coenca-ni/PF-EsterMesquita-SIM/01-Aplicativo/README.md

# Programação em Blocos do Aplicativo

Este diretório contém a programação em blocos do aplicativo desenvolvida utilizando a plataforma Kodular. Os blocos representam a lógica de navegação, controle de rede e outras funcionalidades do aplicativo. Cada bloco possui uma função específica e contribui para a funcionalidade geral do sistema.

## Estrutura dos Blocos

- **Navegação entre Telas**: Blocos que controlam a navegação entre diferentes telas do aplicativo.
- **Controle de Conectividade**: Blocos responsáveis por gerenciar conexões WiFi e resetar o sistema em caso de perda de conexão.
- **Notificações**: Blocos que exibem mensagens ao usuário para indicar ações necessárias, como conexão à rede WiFi.
- **Animações e Interações**: Blocos que configuram animações e interações para melhorar a experiência do usuário.

## Telas
Na pasta tela estão contidos exemplos dos resultados da elaboração das telas através do design do aplicativo Kodular.

## Ícones e outras Imagens
Nesta pasta estão contidos os ícones e imagens utilizados no aplicativo.
