coenca-ni/PF-EsterMesquita-SIM/00-Códigos/MATLAB/chuva_outubro.png

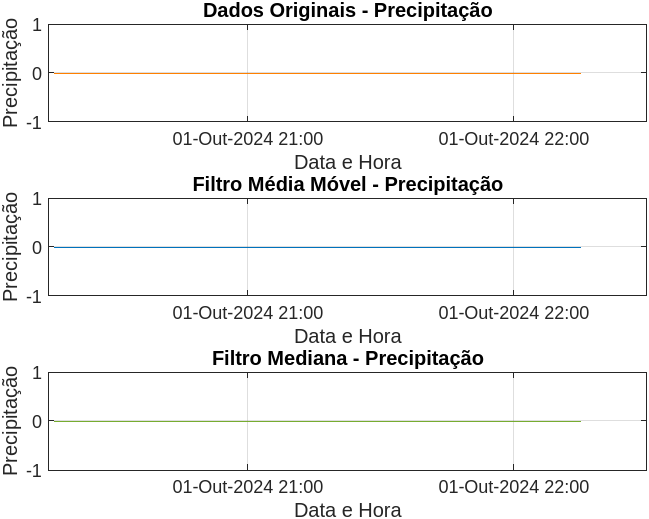
00-Códigos/MATLAB/chuva_outubro.png
