coenca-ni/PF-EsterMesquita-SIM/00-Códigos/MATLAB/indice_uv_outubro.png

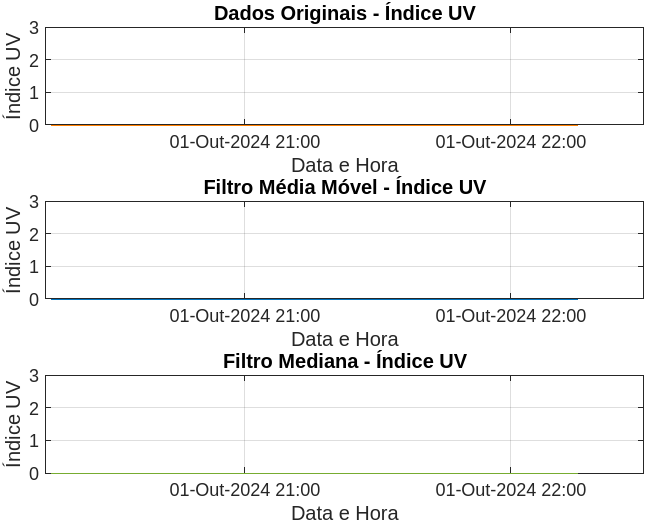
00-Códigos/MATLAB/indice_uv_outubro.png
