coenca-ni/PF-EsterMesquita-SIM/00-Códigos/MATLAB/indiceUV.png

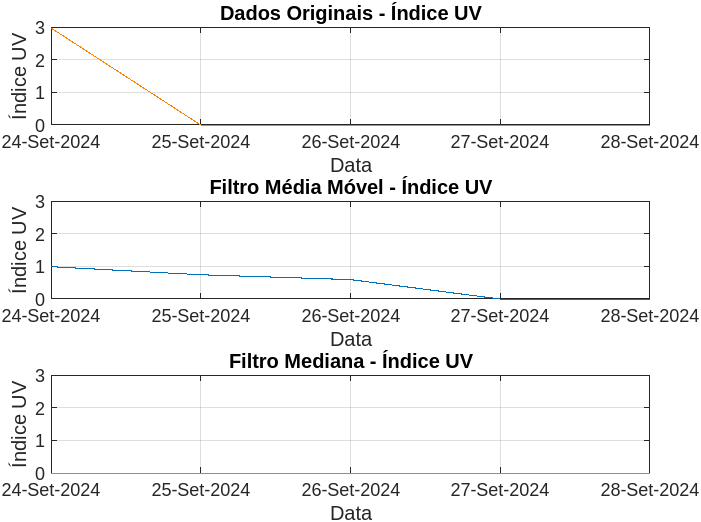
00-Códigos/MATLAB/indiceUV.png
