coenca-ni/PF-EsterMesquita-SIM/00-Códigos/MATLAB/precipitacao.png

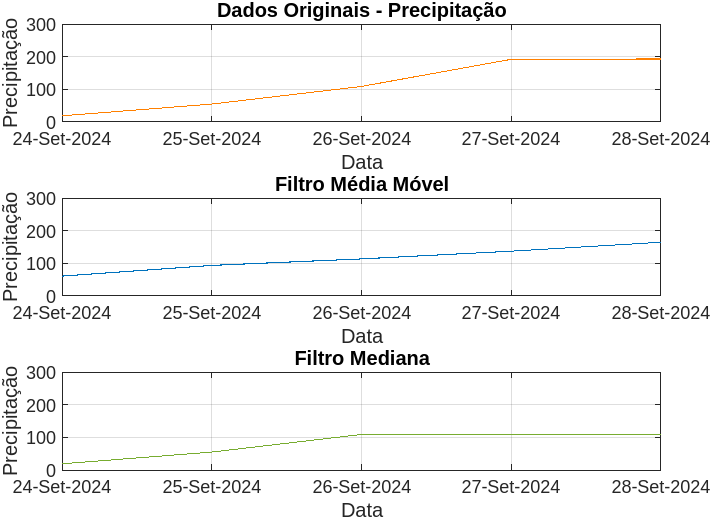
00-Códigos/MATLAB/precipitacao.png
