coenca-ni/PF-EsterMesquita-SIM/00-Códigos/MATLAB/pressao_outubro.png

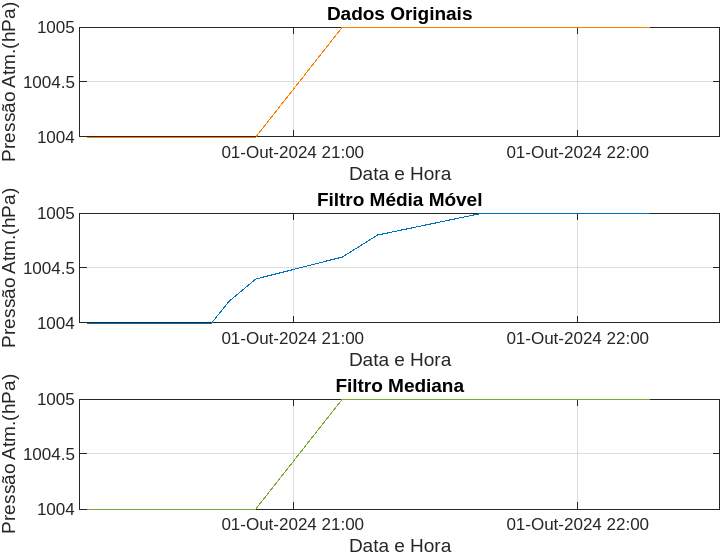
00-Códigos/MATLAB/pressao_outubro.png
