coenca-ni/PF-EsterMesquita-SIM/00-Códigos/MATLAB/QT_outubropng.png

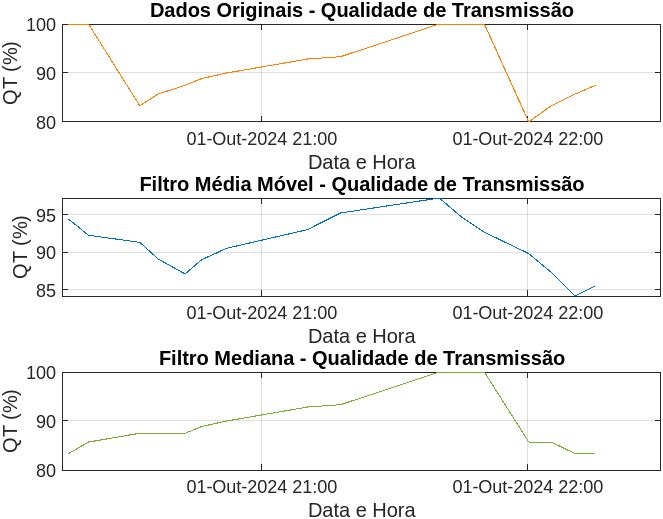
00-Códigos/MATLAB/QT_outubropng.png
