coenca-ni/PF-EsterMesquita-SIM/00-Códigos/MATLAB/temperatura_outubro.png

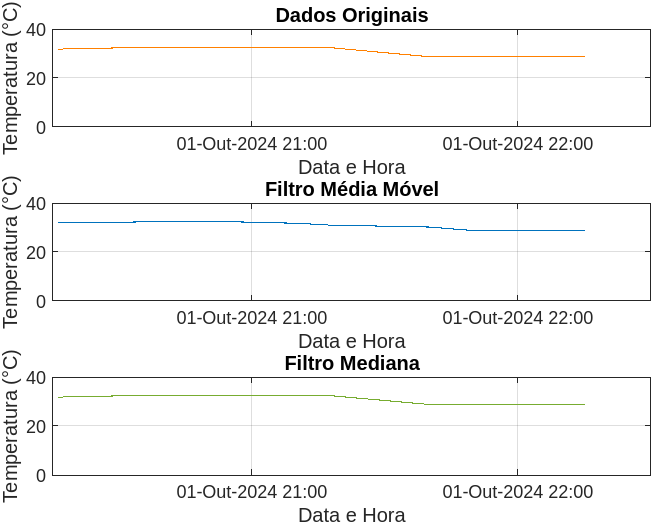
00-Códigos/MATLAB/temperatura_outubro.png
