coenca-ni/PF-EsterMesquita-SIM/00-Códigos/MATLAB/tpp_outubro.png

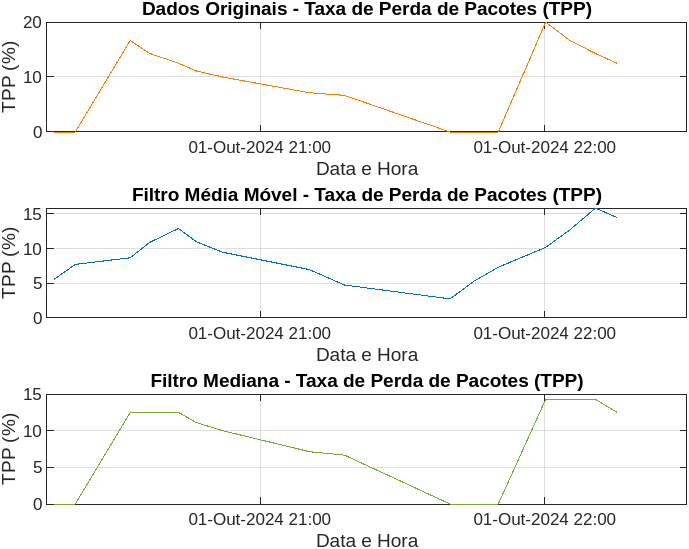
00-Códigos/MATLAB/tpp_outubro.png
