coenca-ni/PF-EsterMesquita-SIM/01-Aplicativo/Blocos/blocks (1).png

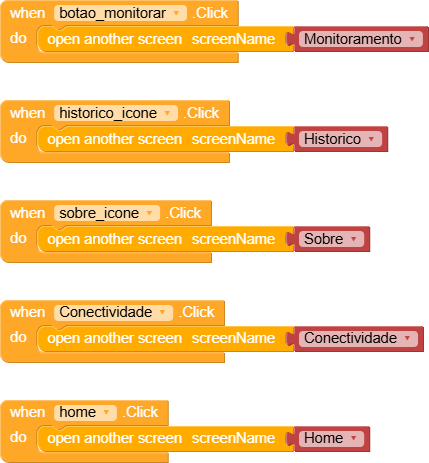
01-Aplicativo/Blocos/blocks (1).png
