coenca-ni/PF-EsterMesquita-SIM/01-Aplicativo/Blocos/blocks (2).png

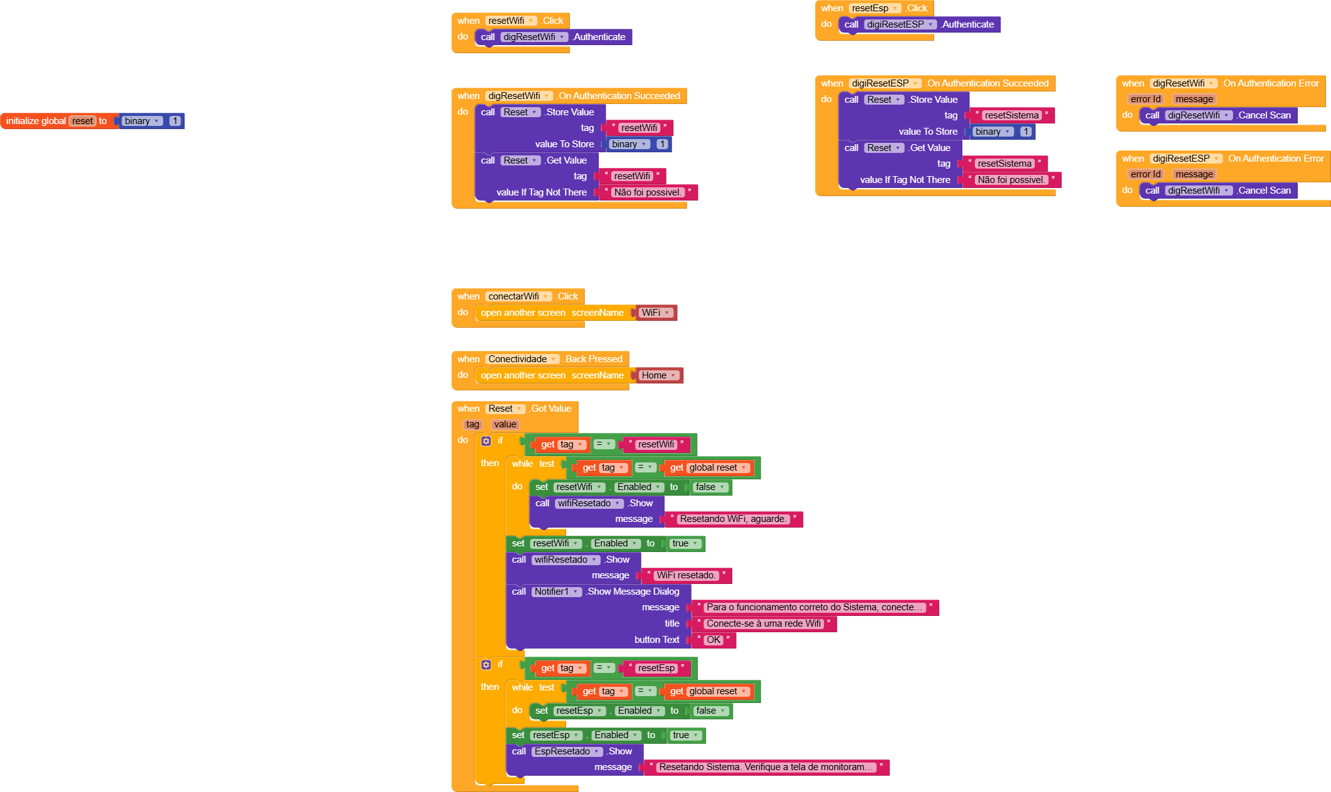
01-Aplicativo/Blocos/blocks (2).png
