coenca-ni/PF-EsterMesquita-SIM/01-Aplicativo/Blocos/blocks (4).png

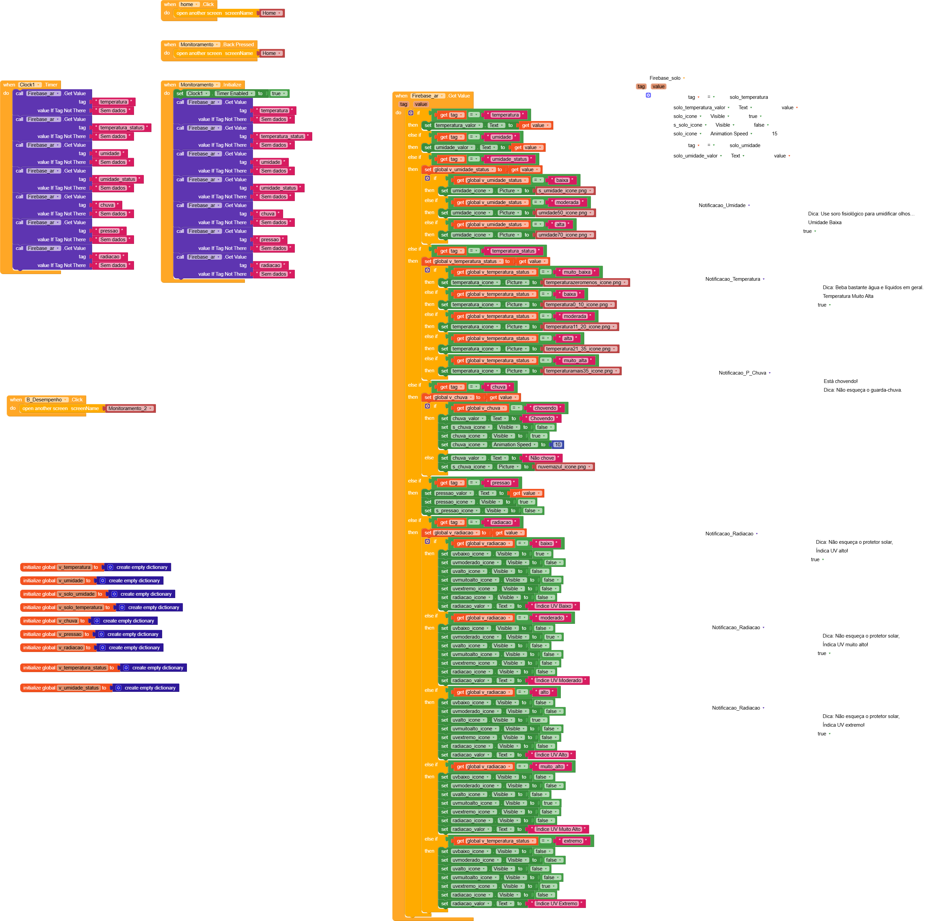
01-Aplicativo/Blocos/blocks (4).png
