coenca-ni/PF-EsterMesquita-SIM/01-Aplicativo/Blocos/blocks (5).png

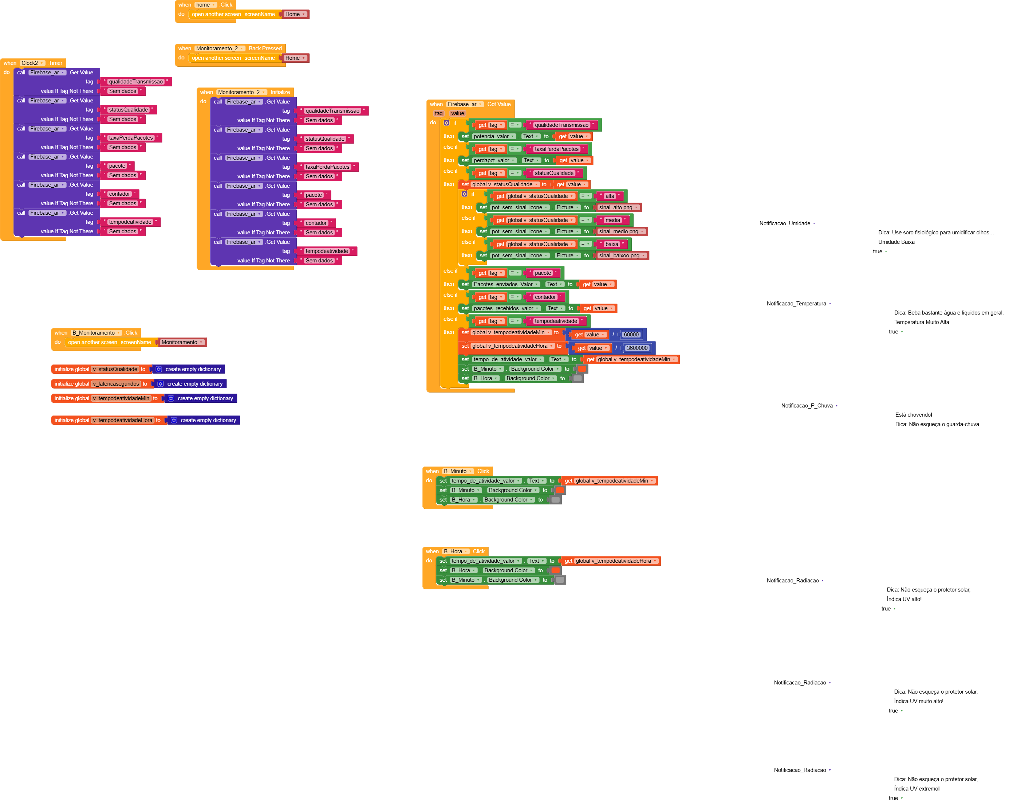
01-Aplicativo/Blocos/blocks (5).png
