coenca-ni/PF-EsterMesquita-SIM/01-Aplicativo/Blocos/blocks (6).png

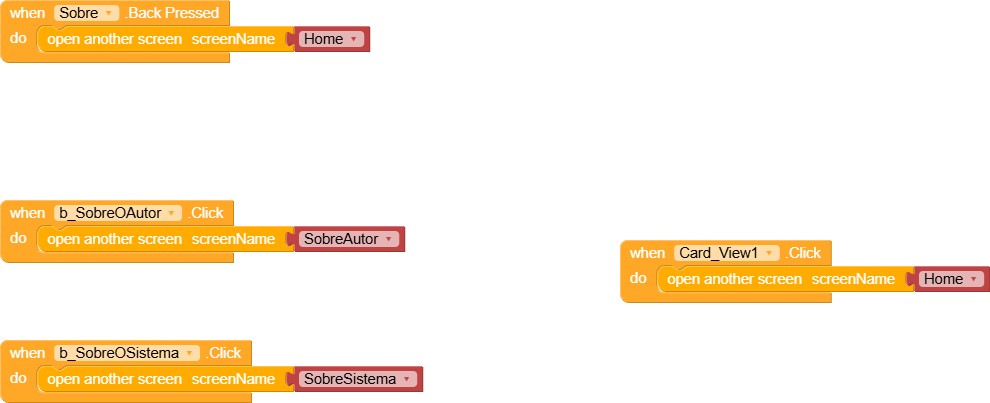
01-Aplicativo/Blocos/blocks (6).png
