coenca-ni/PF-EsterMesquita-SIM/01-Aplicativo/Blocos/blocks (8).png

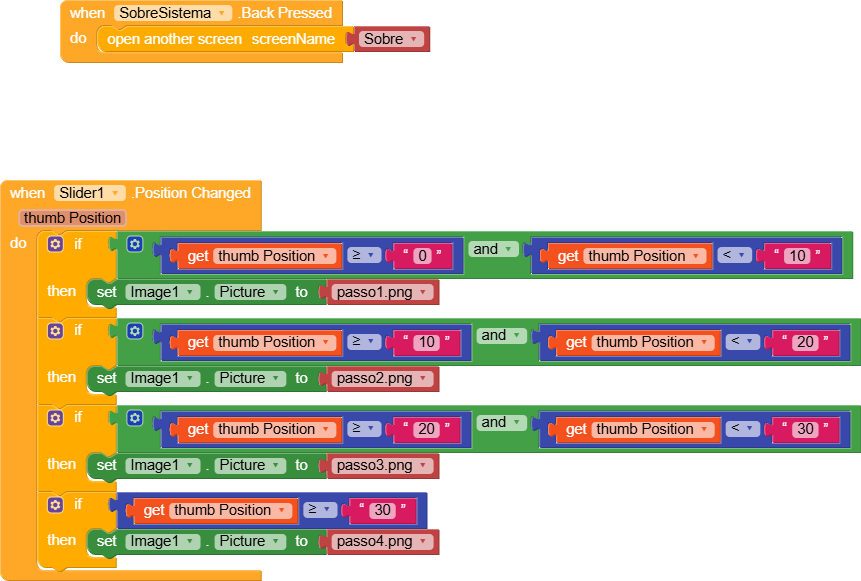
01-Aplicativo/Blocos/blocks (8).png
