coenca-ni/PF-EsterMesquita-SIM/01-Aplicativo/Blocos/blocks (9).png

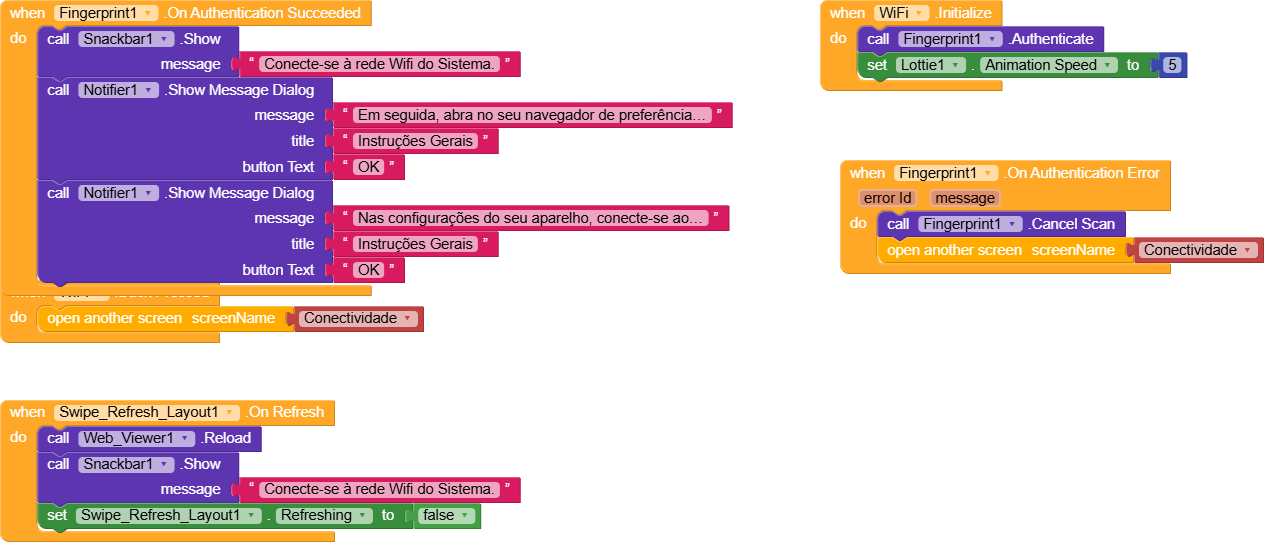
01-Aplicativo/Blocos/blocks (9).png
