coenca-ni/PF-EsterMesquita-SIM/01-Aplicativo/Blocos/blocks.png

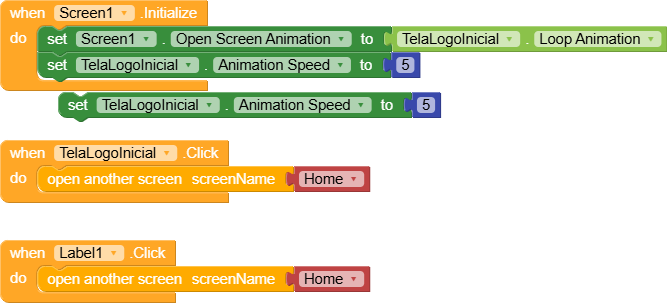
01-Aplicativo/Blocos/blocks.png
