coenca-ni/PF-EsterMesquita-SIM/01-Aplicativo/Telas/Conectar WiFi.png

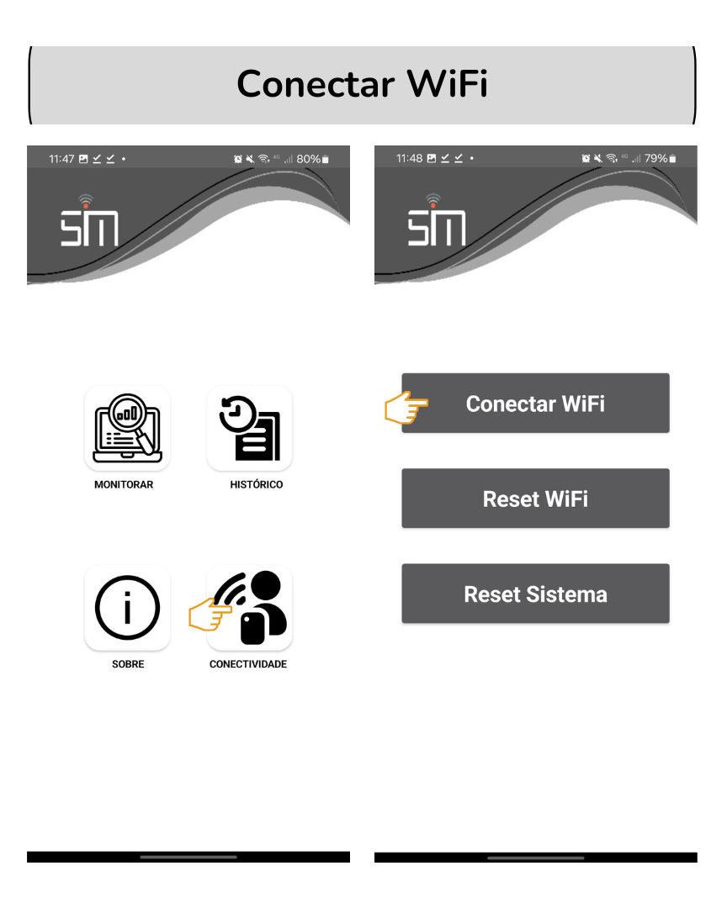
01-Aplicativo/Telas/Conectar WiFi.png
