coenca-ni/PF-EsterMesquita-SIM/01-Aplicativo/Telas/Conectar WiFi_2.png

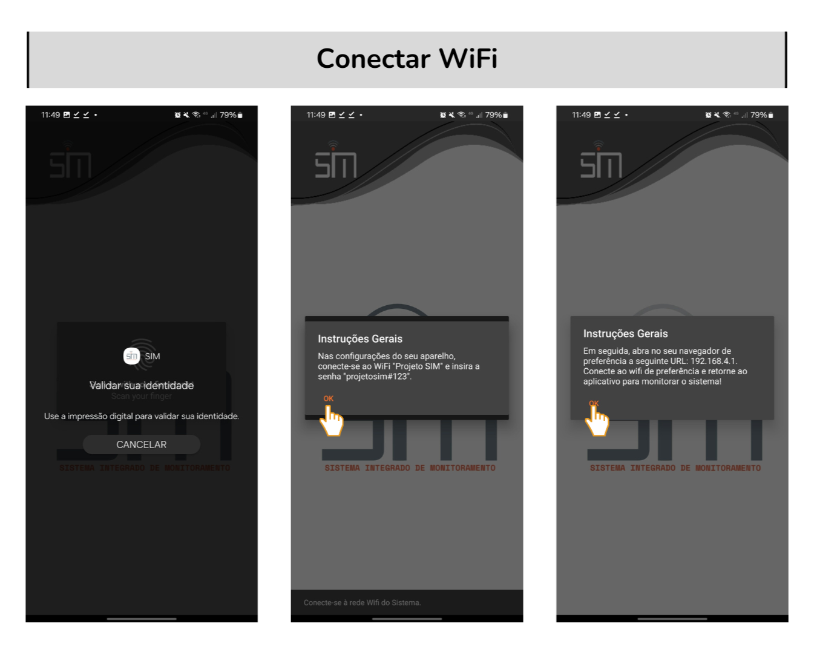
01-Aplicativo/Telas/Conectar WiFi_2.png
