coenca-ni/PF-EsterMesquita-SIM/01-Aplicativo/Telas/Conectar WiFi_3.png

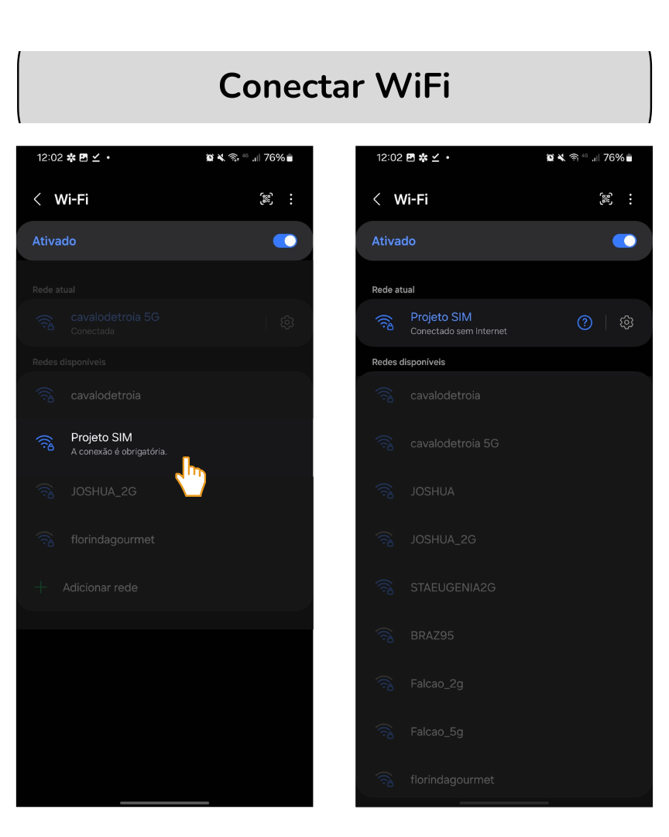
01-Aplicativo/Telas/Conectar WiFi_3.png
