coenca-ni/PF-EsterMesquita-SIM/01-Aplicativo/Telas/Conectar WiFi_4.png

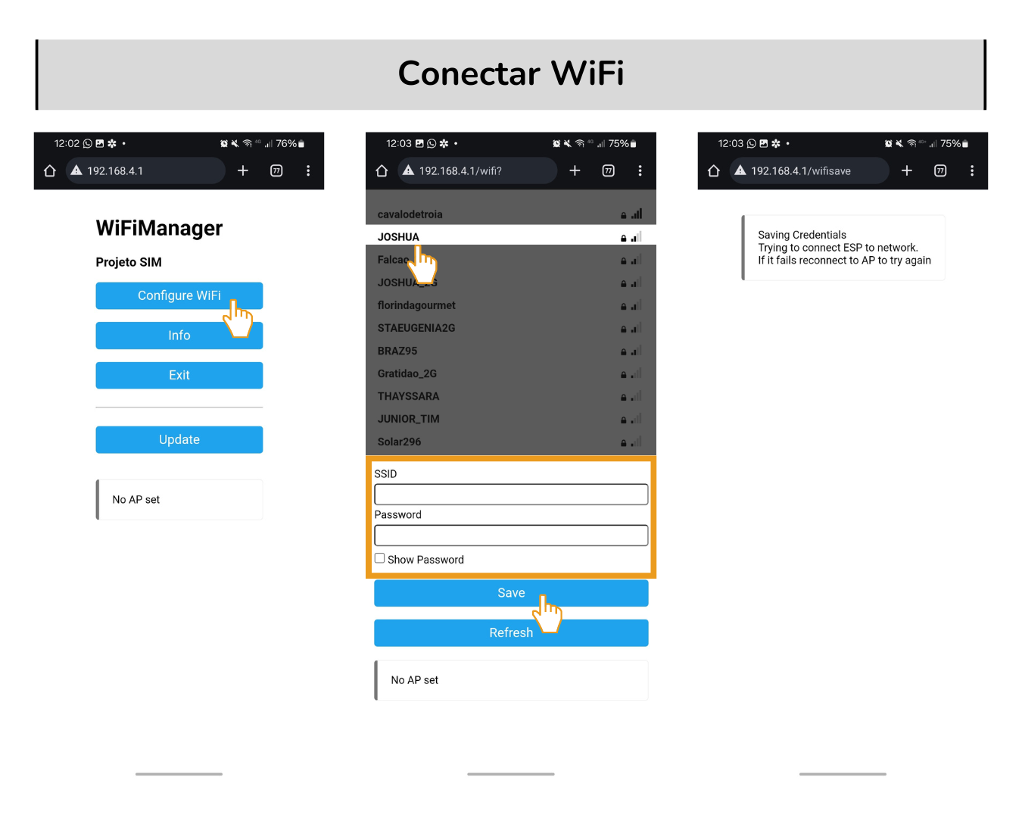
01-Aplicativo/Telas/Conectar WiFi_4.png
