coenca-ni/PF-EsterMesquita-SIM/01-Aplicativo/Telas/Reset Sistema.png

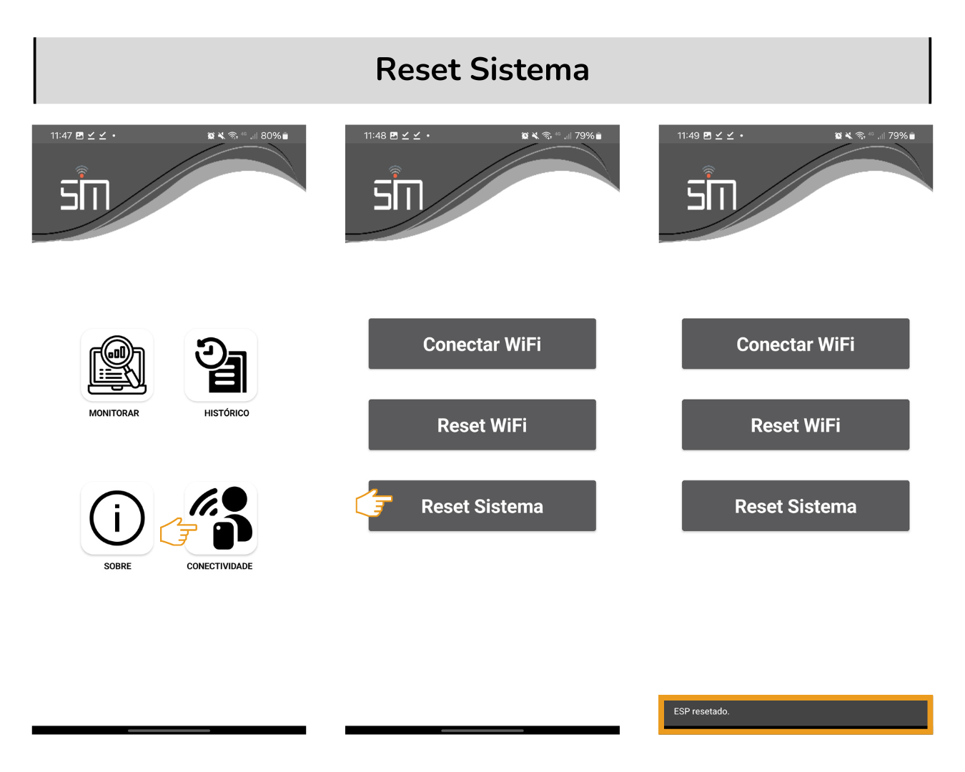
01-Aplicativo/Telas/Reset Sistema.png
