coenca-ni/PF-EsterMesquita-SIM/01-Aplicativo/Telas/Sobre o autor.png

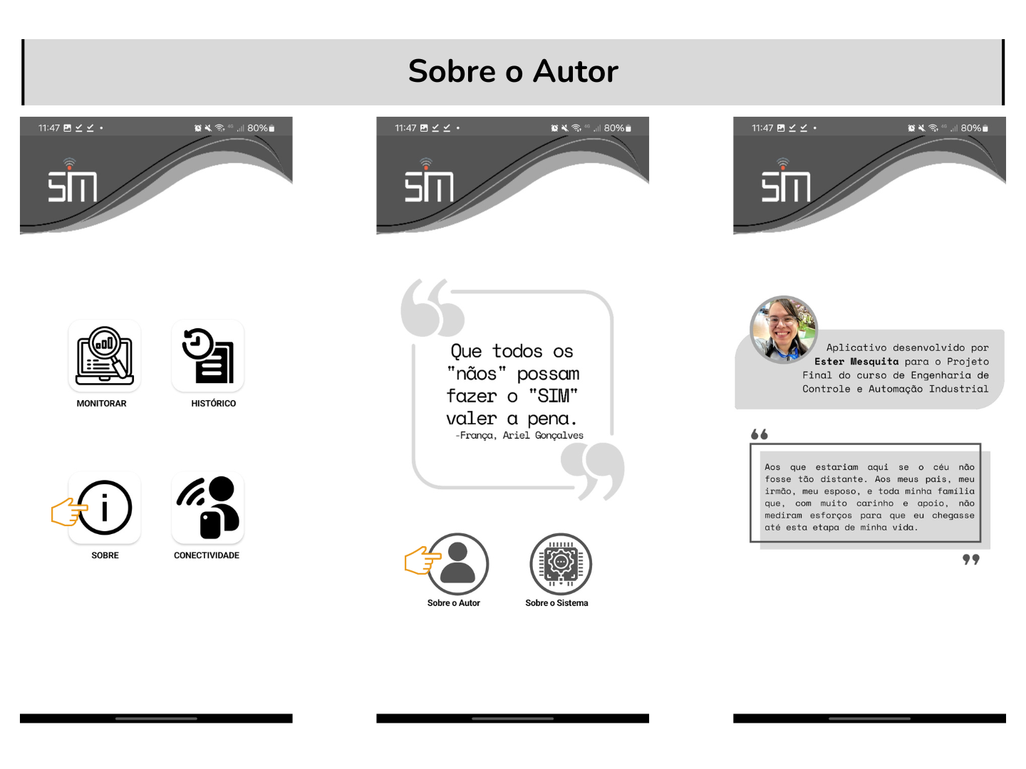
01-Aplicativo/Telas/Sobre o autor.png
