coenca-ni/PF-EsterMesquita-SIM/01-Aplicativo/Telas/Sobre o Sistema.png

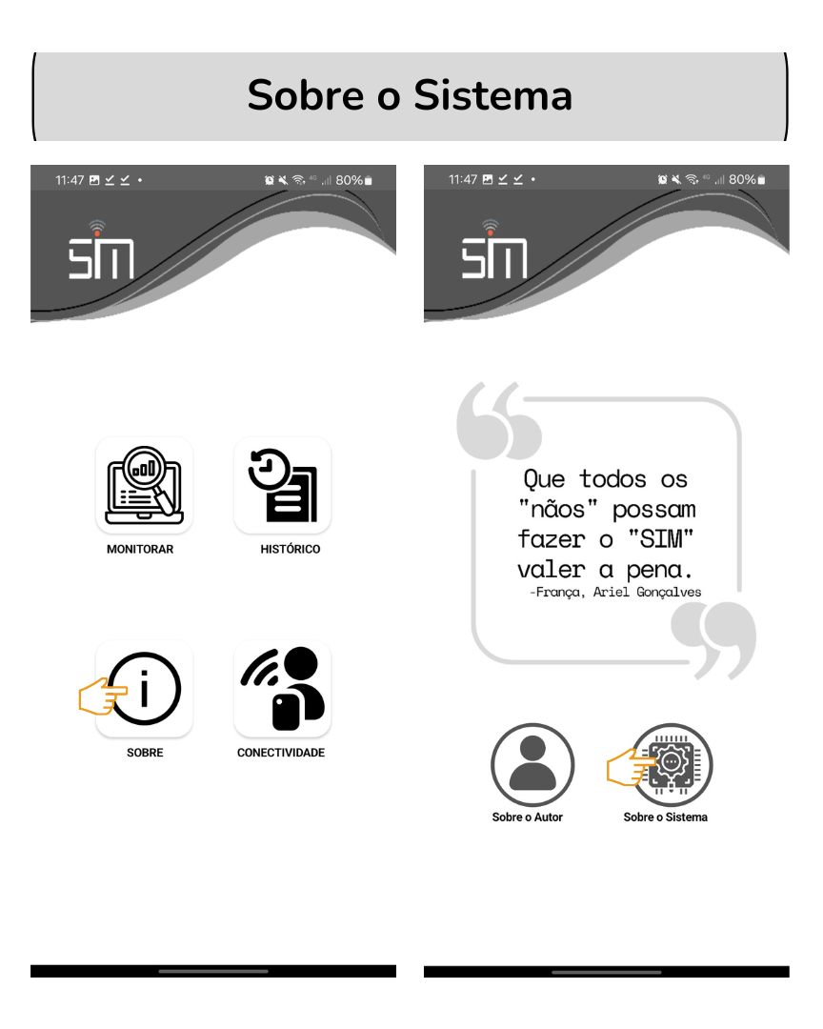
01-Aplicativo/Telas/Sobre o Sistema.png
