coenca-ni/PF-EsterMesquita-SIM/01-Aplicativo/Telas/Sobre o Sistema_2.png

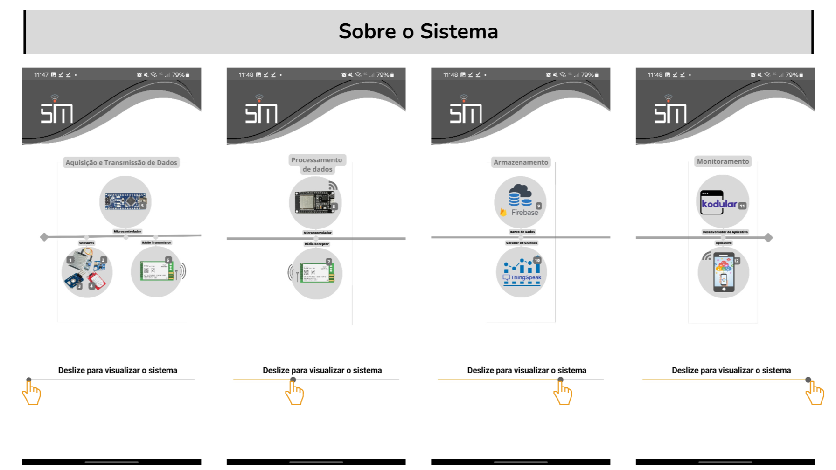
01-Aplicativo/Telas/Sobre o Sistema_2.png
