coenca-ni/PF-EsterMesquita-SIM/01-Aplicativo/Telas/Tela Inicial.png

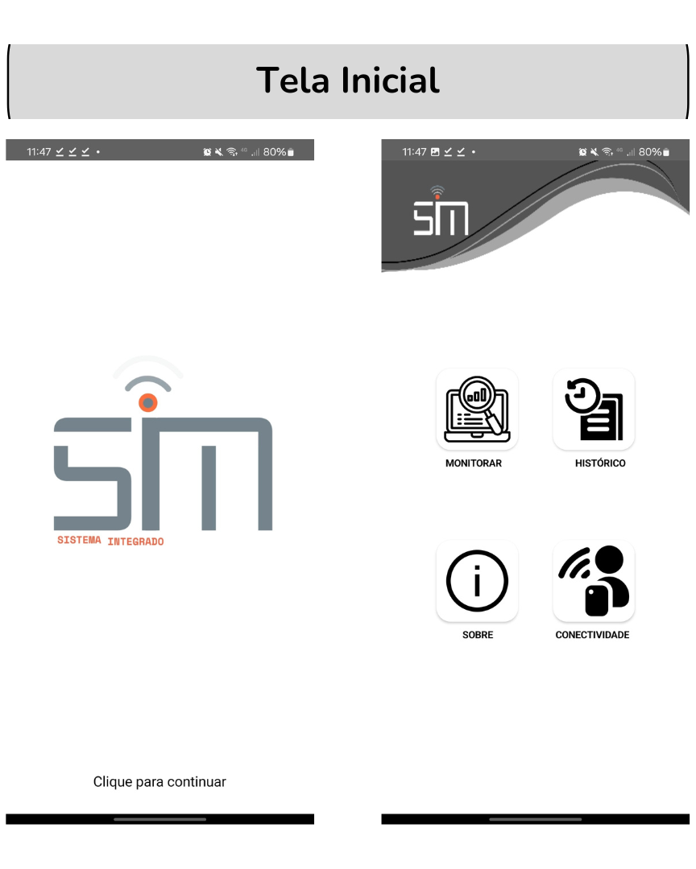
01-Aplicativo/Telas/Tela Inicial.png
