coenca-ni/PF-EsterMesquita-SIM/01-Aplicativo/Ícones e outras imagens/1.png

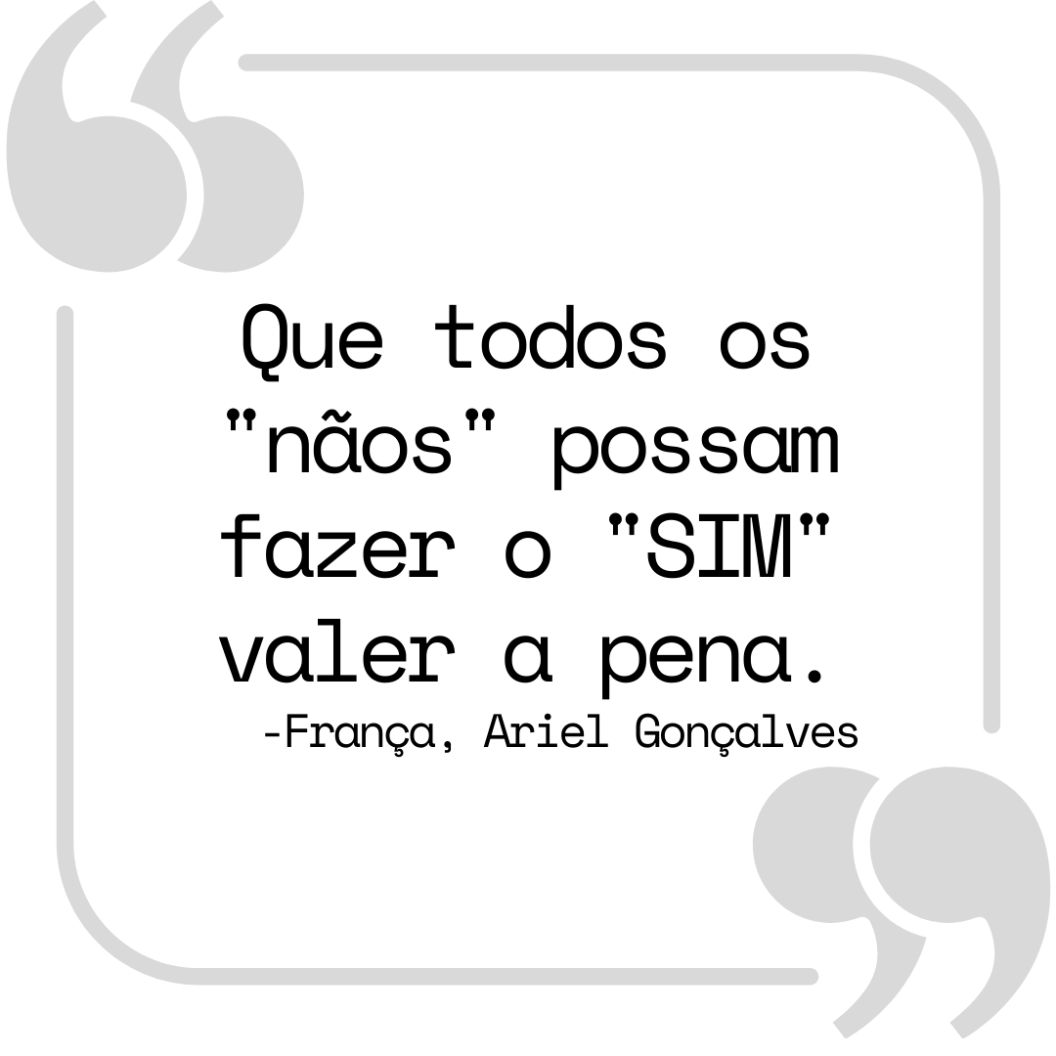
01-Aplicativo/Ícones e outras imagens/1.png
