coenca-ni/PF-EsterMesquita-SIM/01-Aplicativo/Ícones e outras imagens/5.png

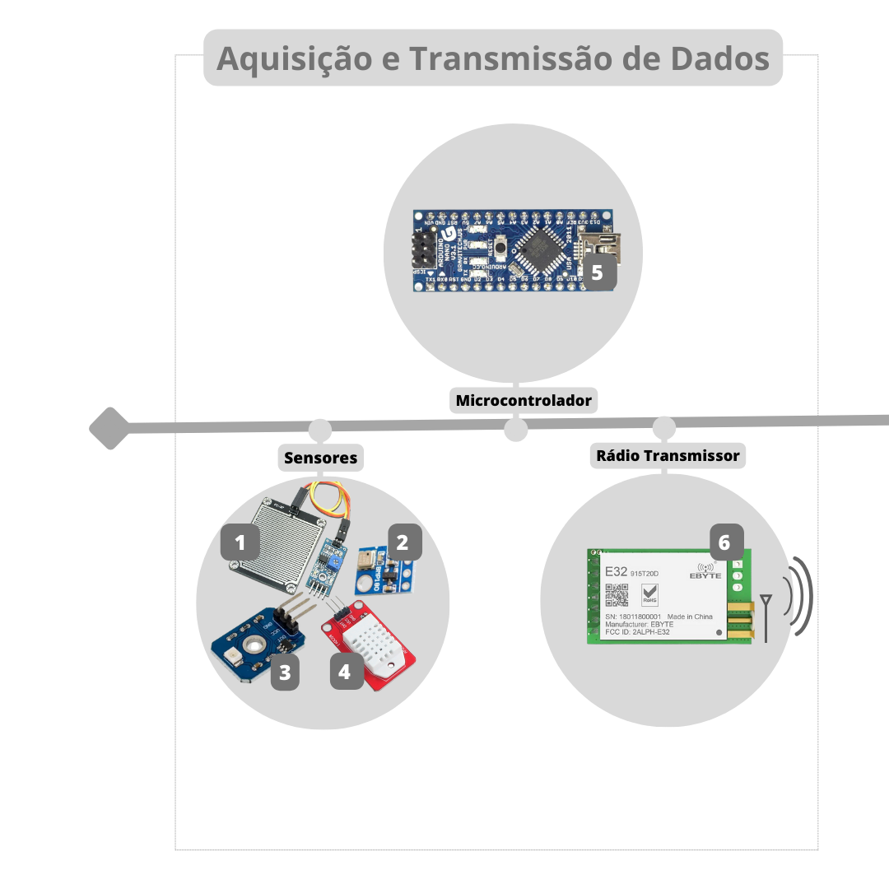
01-Aplicativo/Ícones e outras imagens/5.png
