coenca-ni/PF-EsterMesquita-SIM/01-Aplicativo/Ícones e outras imagens/6.png

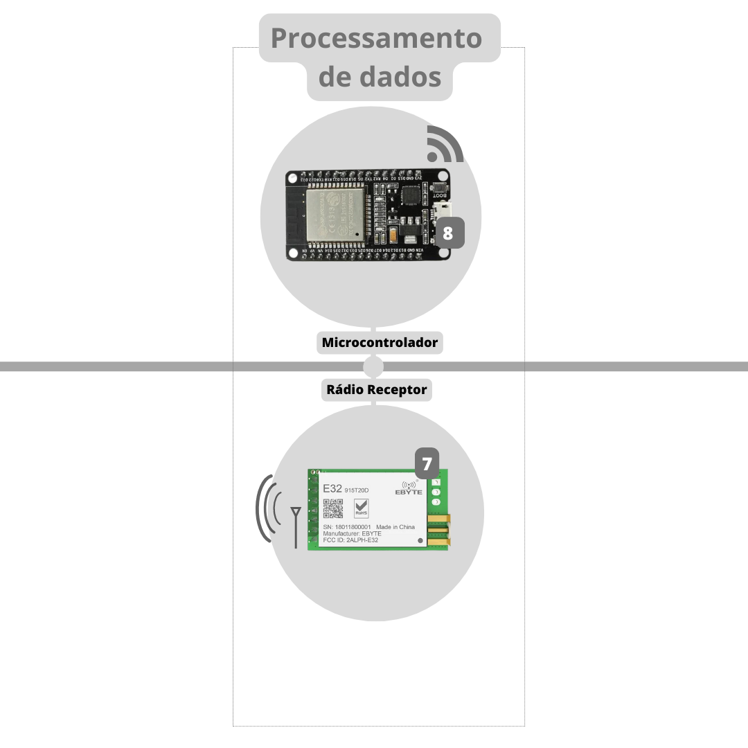
01-Aplicativo/Ícones e outras imagens/6.png
