coenca-ni/PF-EsterMesquita-SIM/01-Aplicativo/Ícones e outras imagens/9.png

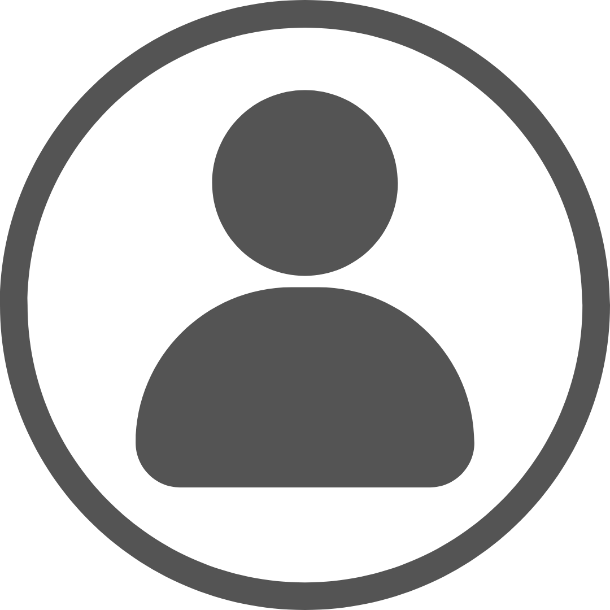
01-Aplicativo/Ícones e outras imagens/9.png
