coenca-ni/PF-EsterMesquita-SIM/01-Aplicativo/Ícones e outras imagens/10.png

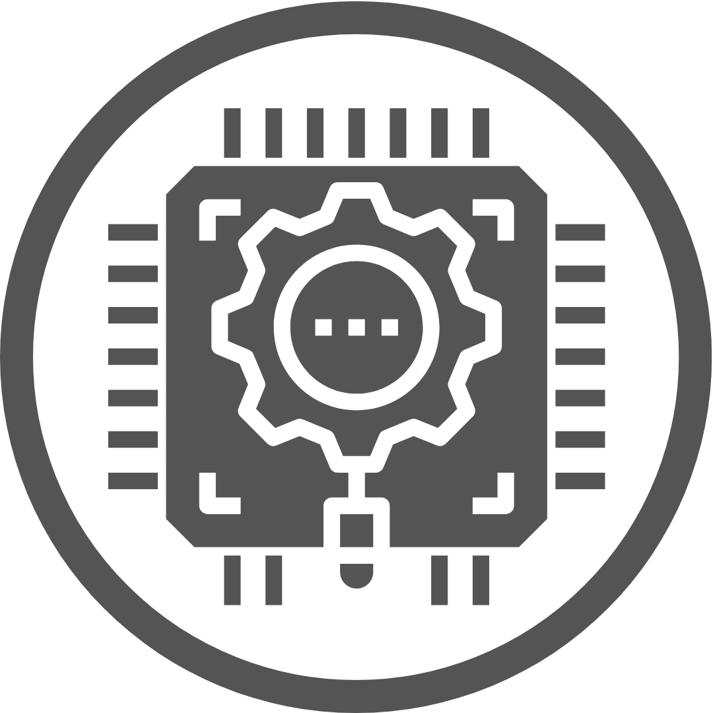
01-Aplicativo/Ícones e outras imagens/10.png
