coenca-ni/PF-EsterMesquita-SIM/01-Aplicativo/Ícones e outras imagens/dedicatoria.png

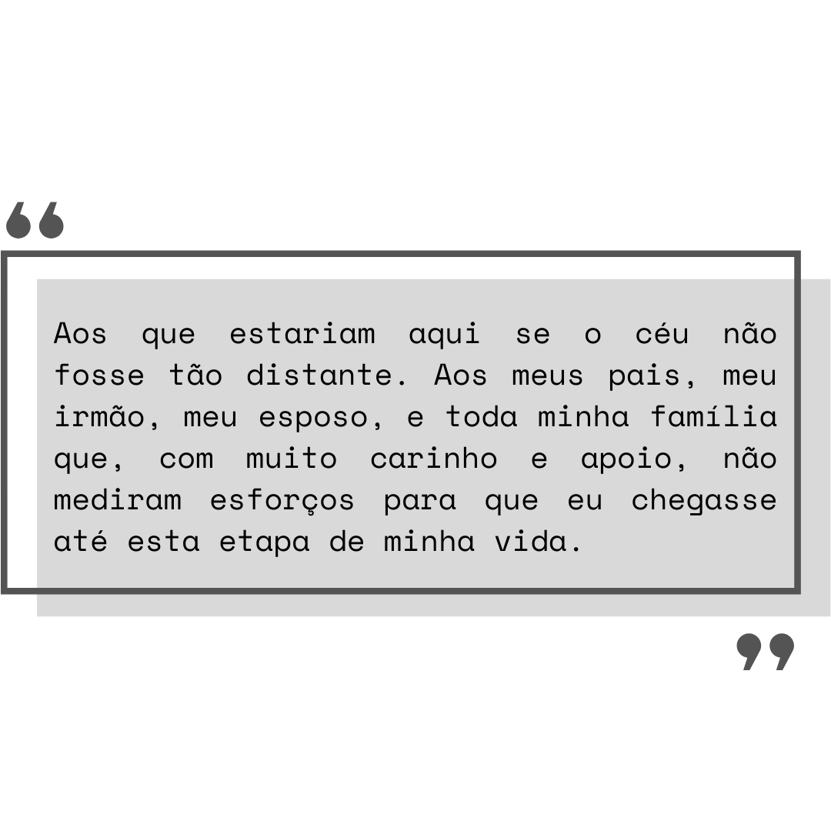
01-Aplicativo/Ícones e outras imagens/dedicatoria.png
