coenca-ni/PF-EsterMesquita-SIM/01-Aplicativo/Ícones e outras imagens/DESEMPENHO.png

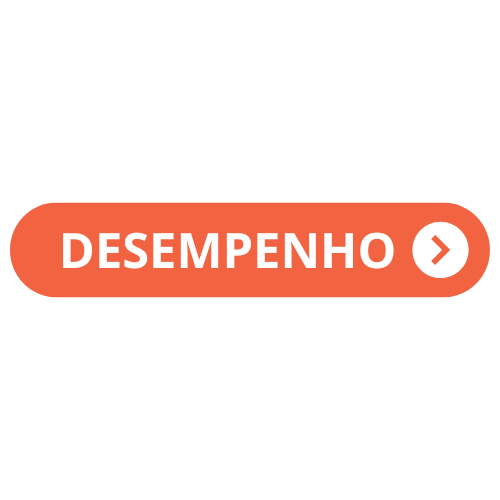
01-Aplicativo/Ícones e outras imagens/DESEMPENHO.png
