coenca-ni/PF-EsterMesquita-SIM/01-Aplicativo/Ícones e outras imagens/MONITORAMENTO.png

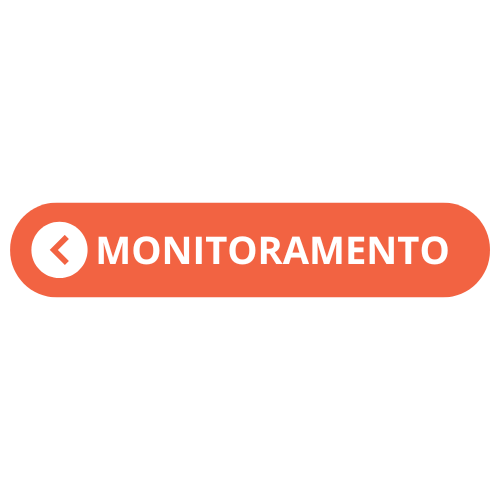
01-Aplicativo/Ícones e outras imagens/MONITORAMENTO.png
