coenca-ni/PF-EsterMesquita-SIM/01-Aplicativo/Ícones e outras imagens/motivacao.png

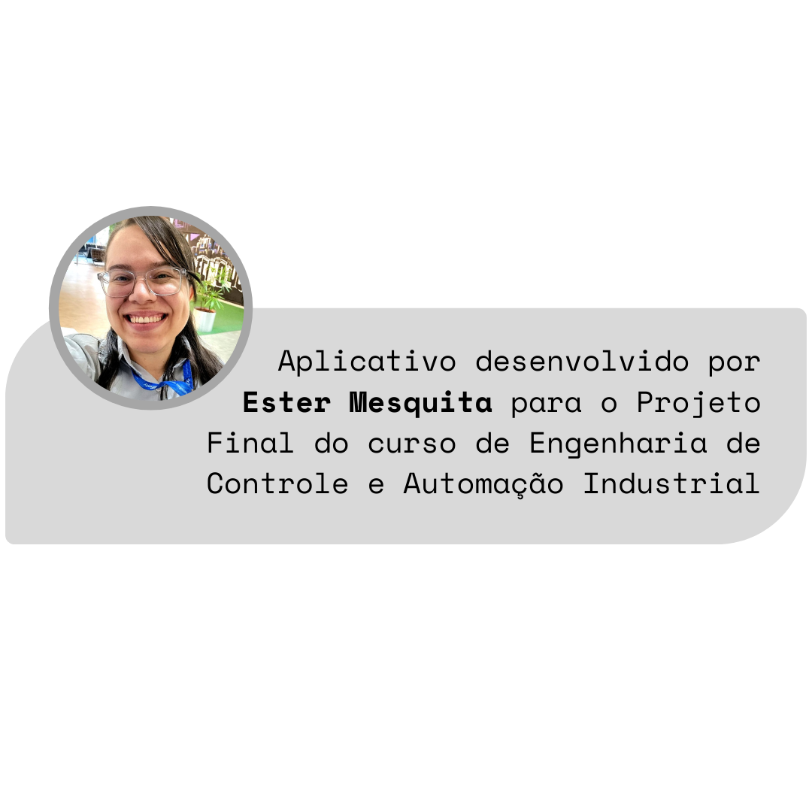
01-Aplicativo/Ícones e outras imagens/motivacao.png
