coenca-ni/PF-EsterMesquita-SIM/01-Aplicativo/Ícones e outras imagens/perda de pacotes.png

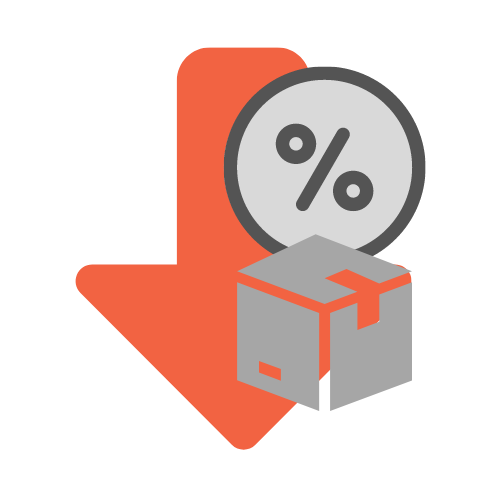
01-Aplicativo/Ícones e outras imagens/perda de pacotes.png
