coenca-ni/PF-EsterMesquita-SIM/01-Aplicativo/Ícones e outras imagens/qualidade.png

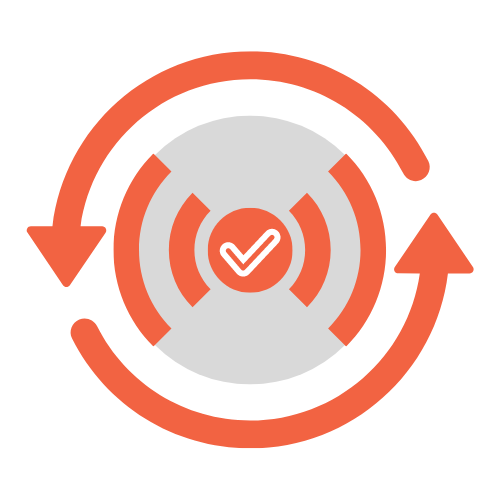
01-Aplicativo/Ícones e outras imagens/qualidade.png
