coenca-ni/PF-EsterMesquita-SIM/01-Aplicativo/Ícones e outras imagens/sem_sinal.png

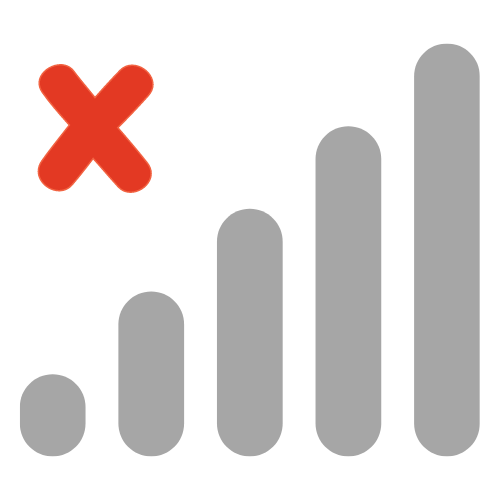
01-Aplicativo/Ícones e outras imagens/sem_sinal.png
