coenca-ni/PF-EsterMesquita-SIM/01-Aplicativo/Ícones e outras imagens/setadir.png

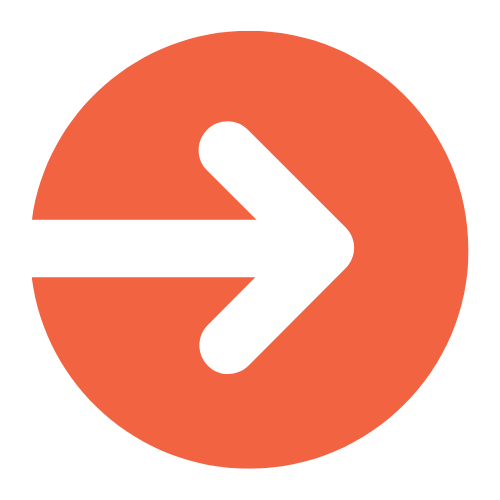
01-Aplicativo/Ícones e outras imagens/setadir.png
