coenca-ni/PF-EsterMesquita-SIM/01-Aplicativo/Ícones e outras imagens/setaesq.png

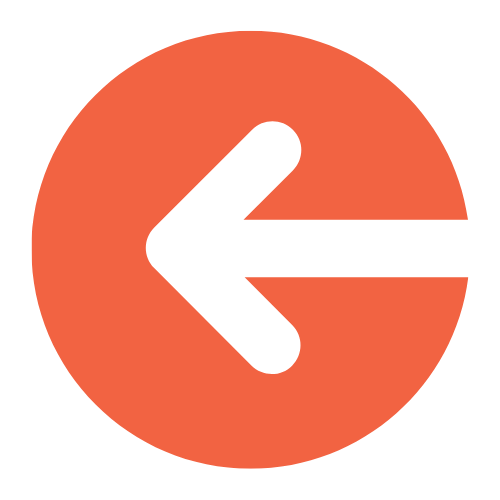
01-Aplicativo/Ícones e outras imagens/setaesq.png
