coenca-ni/PF-EsterMesquita-SIM/01-Aplicativo/Ícones e outras imagens/sinal_alto.png

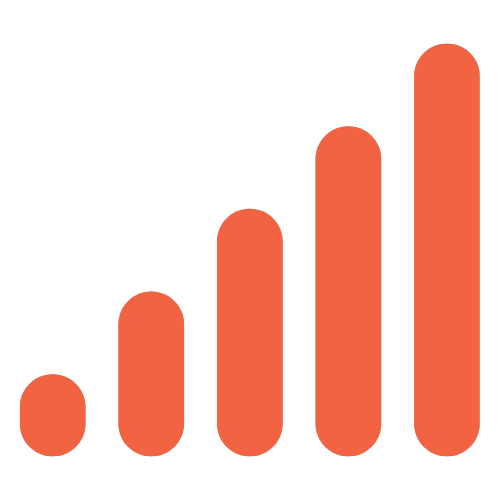
01-Aplicativo/Ícones e outras imagens/sinal_alto.png
