coenca-ni/PF-EsterMesquita-SIM/01-Aplicativo/Ícones e outras imagens/SOBRE - SEM GIF.png

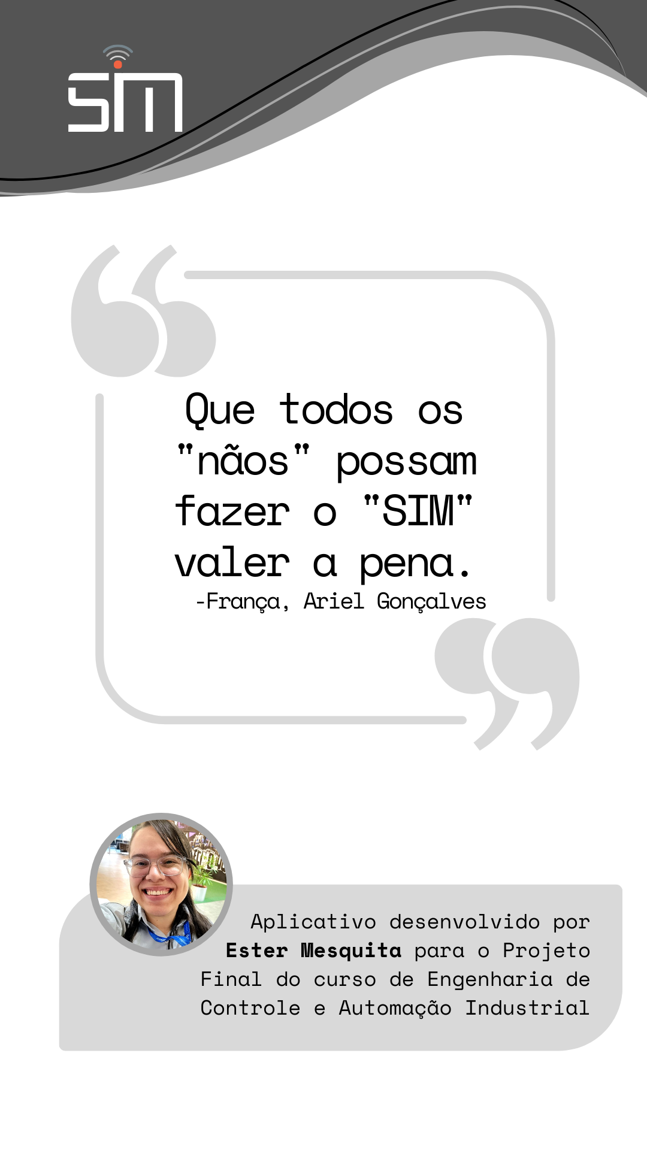
01-Aplicativo/Ícones e outras imagens/SOBRE - SEM GIF.png
