coenca-ni/PF-EsterMesquita-SIM/01-Aplicativo/Ícones e outras imagens/TELA INICIAL - ESCOPO (2).png

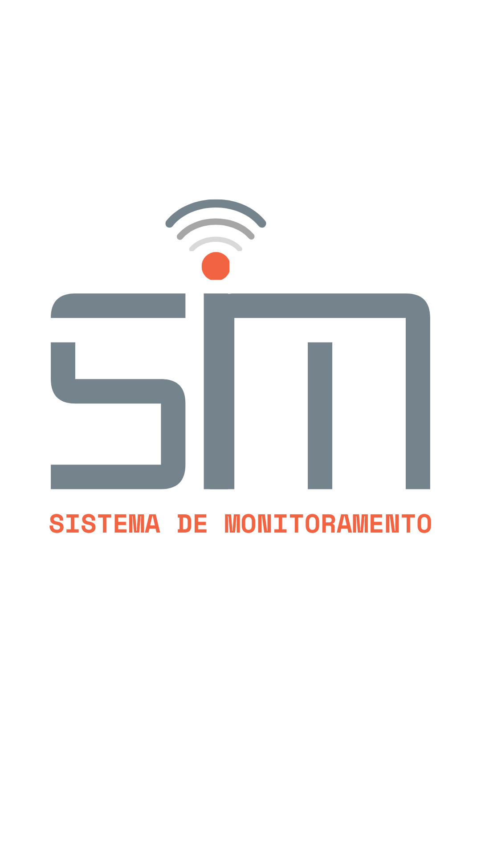
01-Aplicativo/Ícones e outras imagens/TELA INICIAL - ESCOPO (2).png
