coenca-ni/PF-EsterMesquita-SIM/01-Aplicativo/Ícones e outras imagens/TELA INICIAL - ESCOPO GIF.png

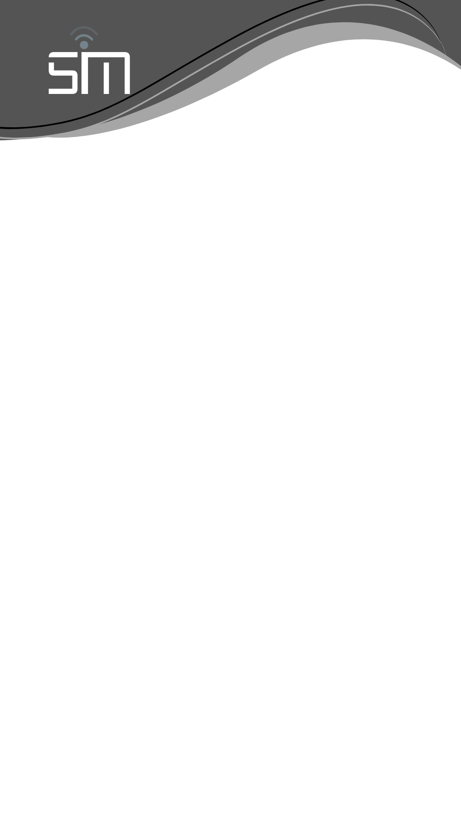
01-Aplicativo/Ícones e outras imagens/TELA INICIAL - ESCOPO GIF.png
